Gustavomurta/ESP32-DVM/ESP32_DVM7135_bug at I2C 02.JPG

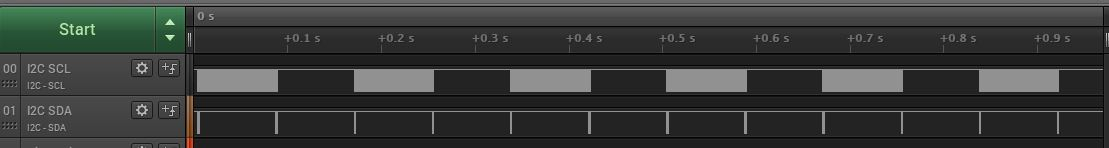
ESP32_DVM7135_bug at I2C 02.JPG
