Gustavomurta/ESP32-DVM/ESP32_DVM7135_bug at I2C.JPG

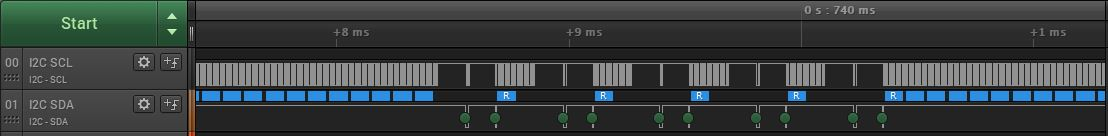
ESP32_DVM7135_bug at I2C.JPG
