Gustavomurta/ESP32-DVM/ESP32 Android tela 01.png

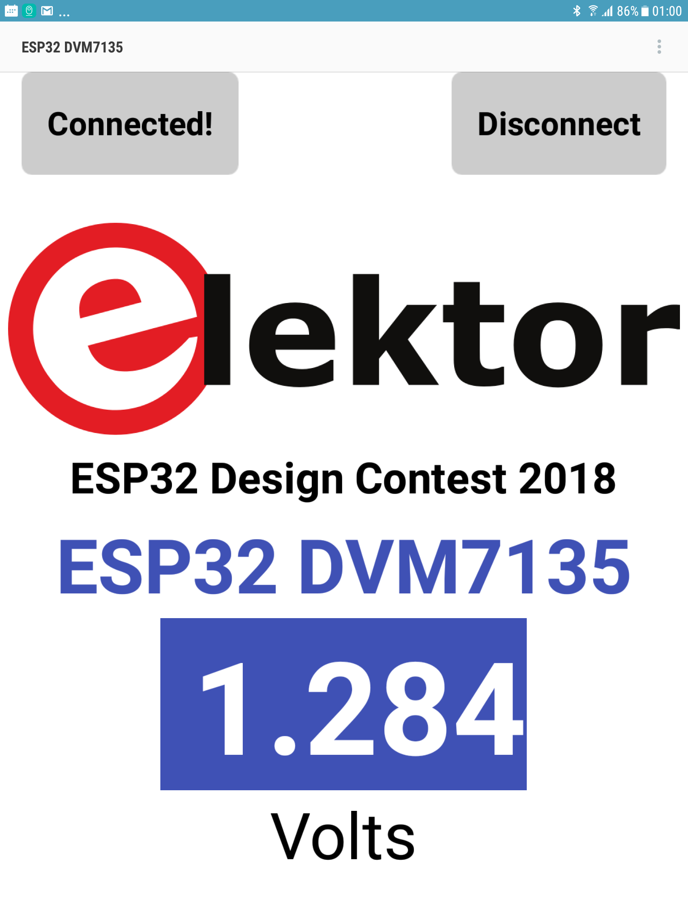
ESP32 Android tela 01.png
