Gustavomurta/ESP32-DVM/ESP32 DVM7135 Blynk01.png

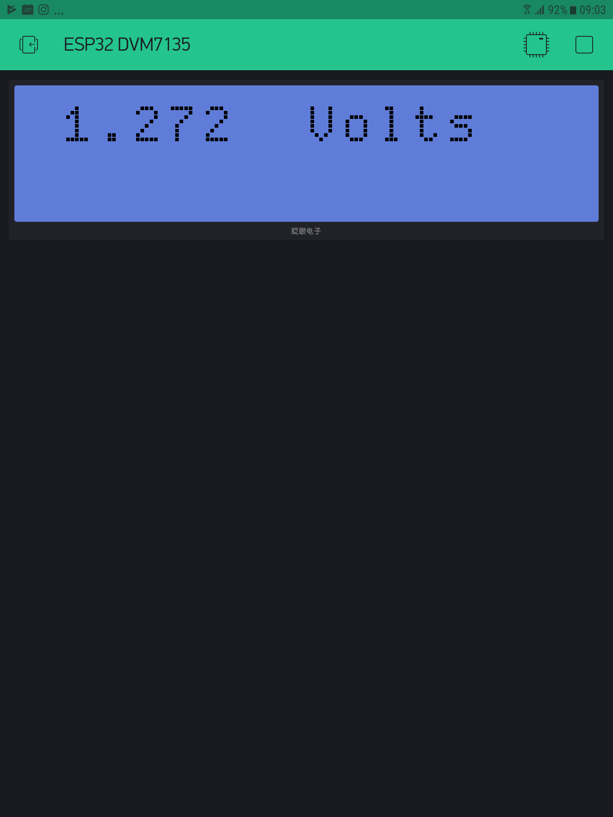
ESP32 DVM7135 Blynk01.png
