Gustavomurta/ESP32-DVM/ESP32 DVM7135 F01.JPG

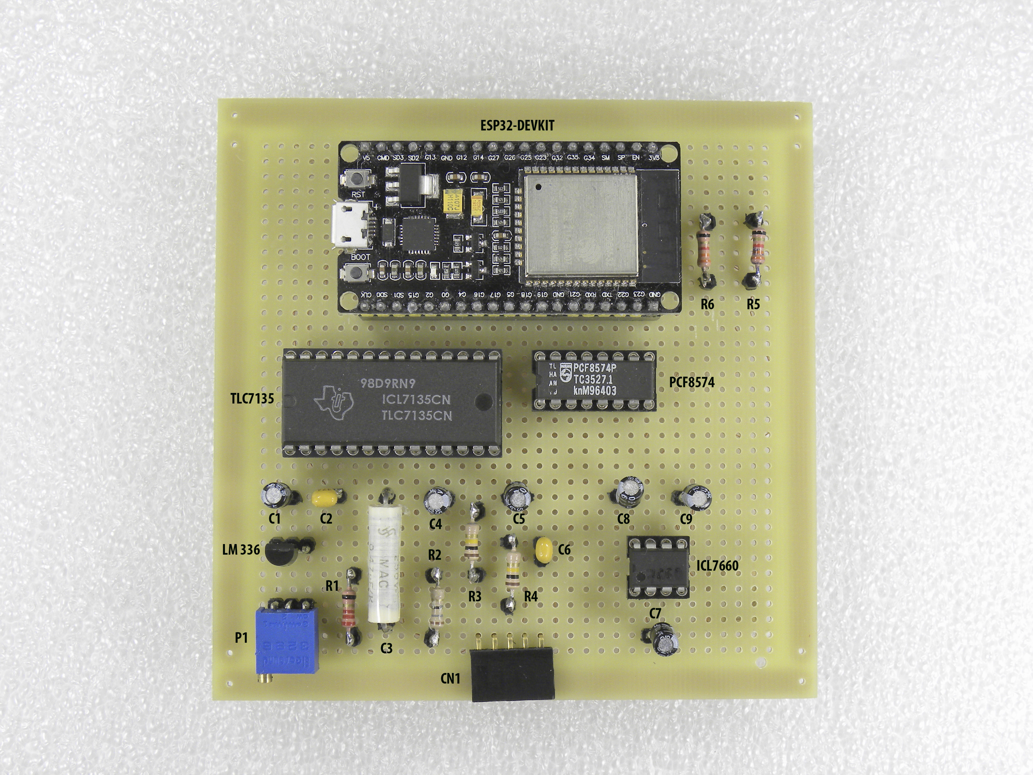
ESP32 DVM7135 F01.JPG
