Gustavomurta/ESP32-DVM/ESP32 DVM7135 F02.jpg

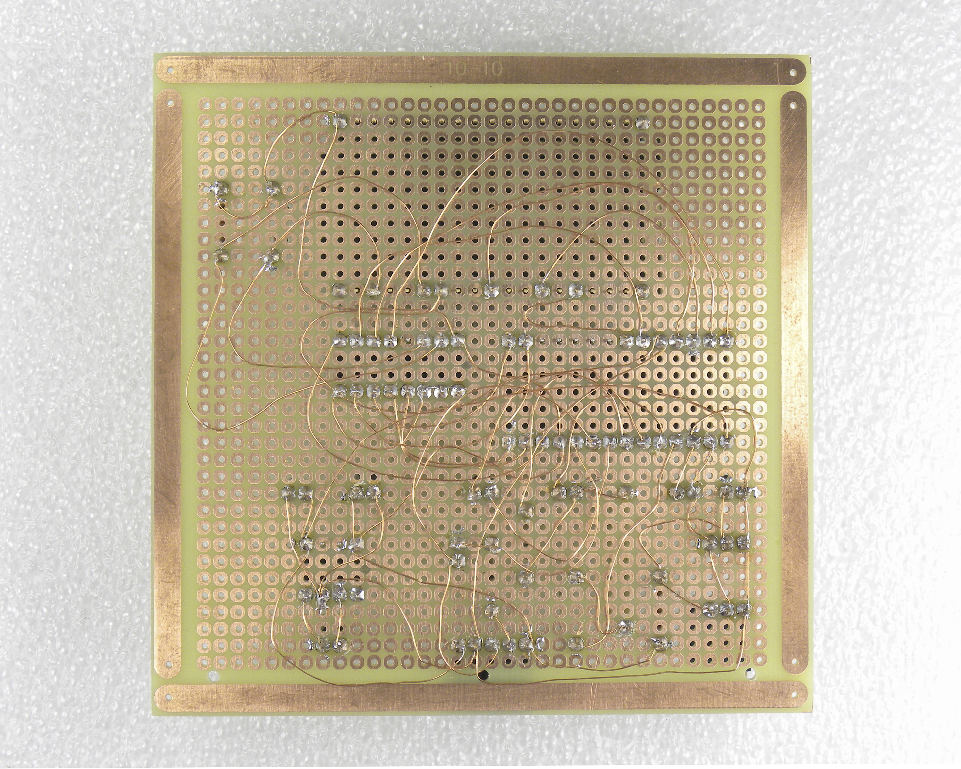
ESP32 DVM7135 F02.jpg
