Gustavomurta/ESP32-DVM/ESP32 DVM7135 V3.jpg

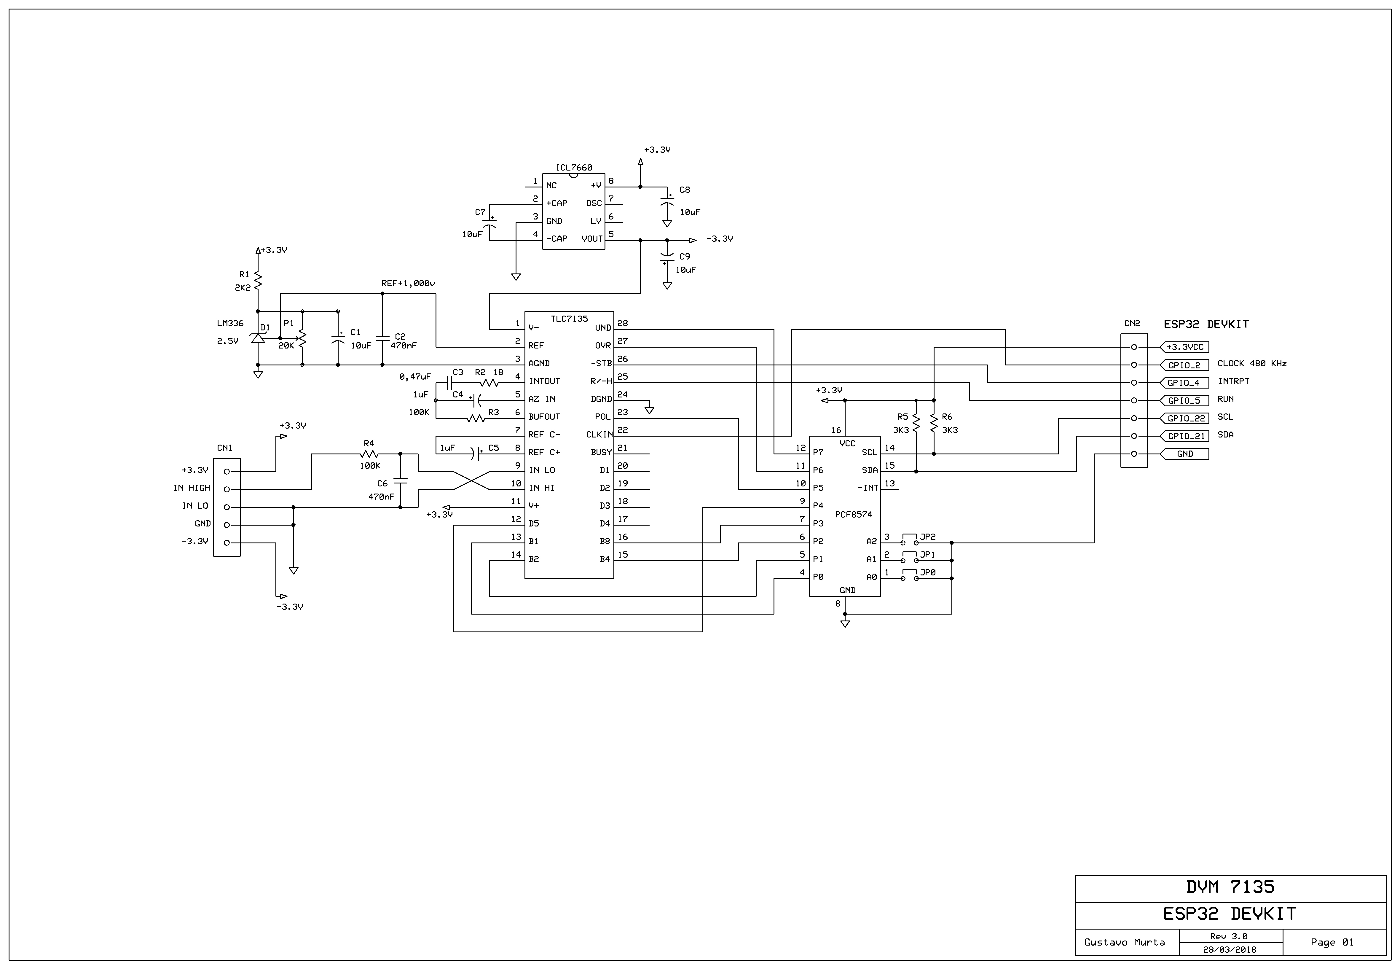
ESP32 DVM7135 V3.jpg
