Gustavomurta/ESP32-DVM/ESP32_DVM7135_data01.JPG

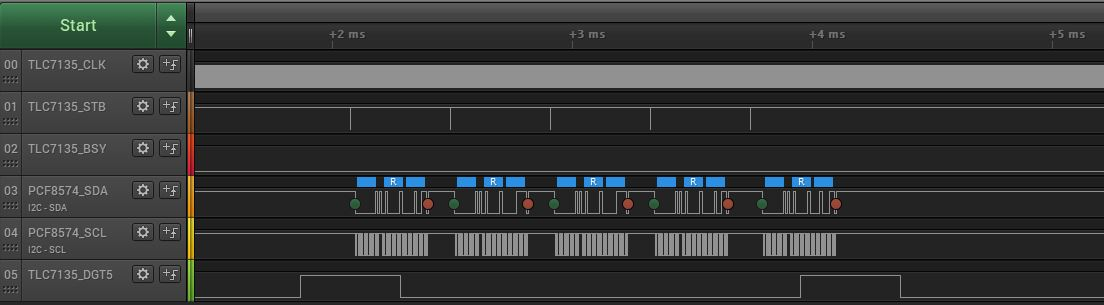
ESP32_DVM7135_data01.JPG
