Gustavomurta/ESP32-DVM/ESP32_DVM7135_DS5 reading.JPG

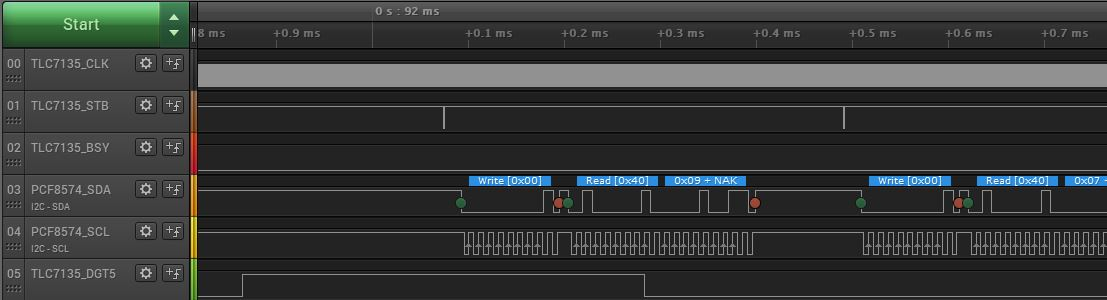
ESP32_DVM7135_DS5 reading.JPG
