Gustavomurta/ESP32-DVM/(commit log)

2018-03-07 Create README.md
    ESP32 DVM - ESP32 Elektor Design Contest 2018
    https://www.elektormagazine.com/labs/contest/esp32-design-contest-2018
2018-03-07 Update and rename ESP32_DVM7135_Prototype_1.ino to ESP32_DVM7135_PT_V1.INO
2018-03-22 ESP32 DVM7135 - Blynk IOT Tests
    ESP32 DVM7135 sending voltages values to my Tablet .
    Using Blynk Platform IOT - https://www.blynk.cc/
2018-03-28 ESP32 - DVM7135 - final schematic
2018-03-28 ESP32 - DVM7135 PCB with wired connections
2018-03-28 ESP32 - DVM7135 PCB with wired connections (low side)
2018-03-31 ESP32 DVM7135 Android Bluettoth APP
2018-03-31 ESP32 DVM7135 Blynk IOT WIFI (screen copy)
2019-07-01 ESP32 I2C scanner (based on Nick Gamon)
2019-07-01 Add files via upload
    Logic analyzer diagram.
    ESP32 reading voltage from TLC7135.
2019-07-01 Add files via upload
    ESP32 readind Digit 5 (D5) data.
2019-07-01 Add files via upload
    With new ESP32 Arduino Core 1.0.2, the I2C interface runs in wrong mode
2019-07-01 Add files via upload
    Chuck test - I2C pins
2019-07-02 Add files via upload
    Logic Analyzer - timing diagram of my ESP32 DVM running.
